scottalmond/InfoBadge/pcb/draft_1-1/img/askew.png

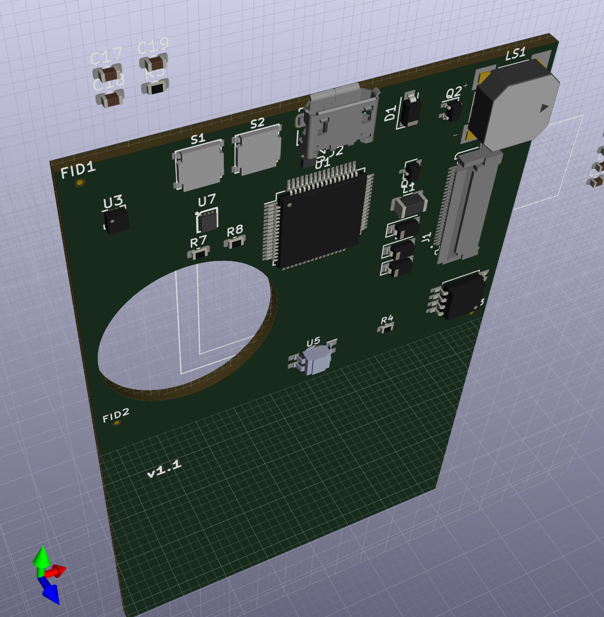
pcb/draft_1-1/img/askew.png
