scottalmond/InfoBadge/README.md

# InfoBadge
Low power wearable badge for quick-access information without wireless connectivity
