scottalmond/InfoBadge/pcb/draft_1-1/fab_notes.txt

*** update schematic license and author CC BY 4.0

*** start routing by connecting 100 nF caps near pads

x ***accel: CW/CCW reverse pins on pads
  actually, pdf view is looking up at chip, thus pads are mirrored on section 9.2, keep KiCAD AS_IS

*** update eletronic egg schematic and drawing annotation at bottom right to rev 1.2

*** verify placement of eInk header with respect to cble length from opposing side of board
*** connect analog reference https://hackaday.io/project/165887-pam8301-breakout-board

How to get debug terminal?
 Arduino Serial.setup(9600); Serial.println("test");

How to do this simple task with Atmel Studio?
  Usb examples only have echo, with no clear way to insert content between the read and write operations.  Useless as a demo of the communication protocol

DAC example non-functional.  Which pin is DAC_0? PA02 as DAC0
*NO* indication of expectations: voltage only goes up to 0.24V (0.12V when looping quickly), though multimeter had a grounding issue offset. had to add delay_ms(10); to see anything recognizable on DMM
test_analog_location3 - reached 3.3V output with 4096 steps
Need to read from PA02; and tie PA03 to ID (3.3V to VREF)

"GETTING-STARTED1.proj":
File > New > Example Project >
Family > SAML21
Search > "started"
Select: Getting-started Application - SAM L21 Xplained Pro B

Upload to target
Use Target USB at 38400 baud for messages (why isn't this terminal a feature in Atmel Studio???)

-- Getting Started Example --
-- SAML21_XPLAINED_PRO --
-- Compiled: Feb 22 2020 18:46:17 --
-- Pressing and release button SW0 should make LED0 on and off --
The output is triggered by TC counter

CONF_STDIO_BAUDRATE is 38400
keywords: configure_console, usart_get_config_defaults, stdio_serial_init, usart_enable

I want to merge "Atmel Start" project with the demo so that I can control PB06 as a debug output.  Having two projects in the same "solution" has poorly explained conflicts (will only compile the second project while igrnoing the first)

trying to add a helper file/function generates build errors

Remidned of Apollo 13 "Let's look at this as a question of status: What do we have that wroks?"

there appear to be mixed generation os libraries between "Getting started" and the "Atmel Start" projects - specifically in port_set_gpio... and gpio_set_digital... naming/usage conventions

HOW TO MERGE libraries between projects?  Want to use the UART/USB described in the "Getting started" project with the KNOWN TO WORK PB06 toggling from "Atmel Start"

Have to read between the lines to determine that a .h file is needed (error messages are useless for help)

like trying to combine two south magnets, IDE fights me every step of the way...

usart_serial_getchar
usart.c
	SercomUsart *const usart_hw = &(module->hw->USART);

	/* Check if USART has new data */
	if (!(usart_hw->INTFLAG.reg & SERCOM_USART_INTFLAG_RXC)) {
		/* Return error code */
		return STATUS_BUSY;
	}
serial.h

Also have been unable to get demo program to run on capacitive touch

usb boot loader: http://ww1.microchip.com/downloads/en/AppNotes/Atmel-42650-SAM-BA-Bootloader-for-SAM-L-Devices_ApplicationNote_AT10840.pdf
ice in production: http://ww1.microchip.com/downloads/en/AppNotes/00002466A.pdf
  https://www.highvoltagecoils.eu/2017/09/12/how-to-use-atmels-atprogram-cli-command-line-interface-to-program-a-production-file-into-an-xmega/

the atmel toolchain *requires* internet acces to make a 'Start' project

"low power" sercom?
 SERCOM5, due to its location in PD0, has a reduced feature set and does not support these features
- spi chip select
TC4 for wake-from-sleep

import arduino library I2C
C:\Users\Logic\Documents\ArduinoData\packages\arduino\hardware\samd\1.8.4\libraries\Wire

View Example Help > Offline Help
is not selectable

ASF explorer/wizard
can this work offline?

New example file frokm ASF or Extensions requires internet access

So atmel studio has a built-in browser but no terminal to communicate with chips?

12 Mhz on PL0 for CPU, 1.2 mA LDO / 0.7 mA on BUCK [Coremark]

--

50 N at 100m depth for 7.62mm dimamter

add BME280 for no particular reason
https://www.kickstarter.com/projects/463050344/ruuvitag-open-source-bluetooth-sensor-beacon
