scottalmond/InfoBadge/pcb/draft_1-1/img/front.png

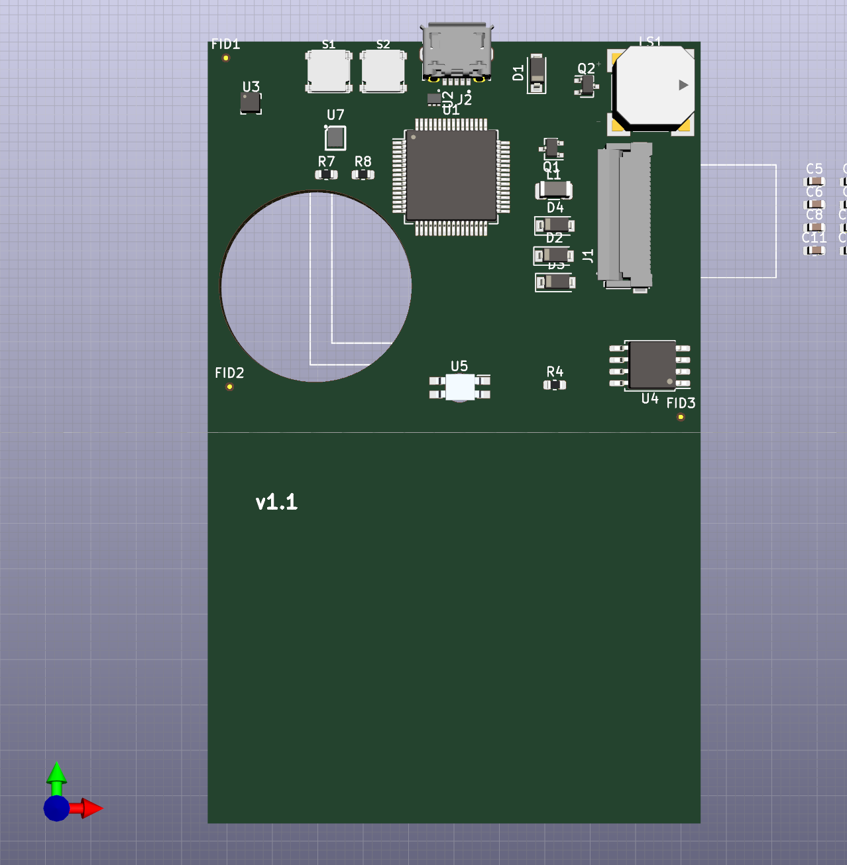
pcb/draft_1-1/img/front.png
