scottalmond/InfoBadge/pcb/draft_1-1/img/rear.png

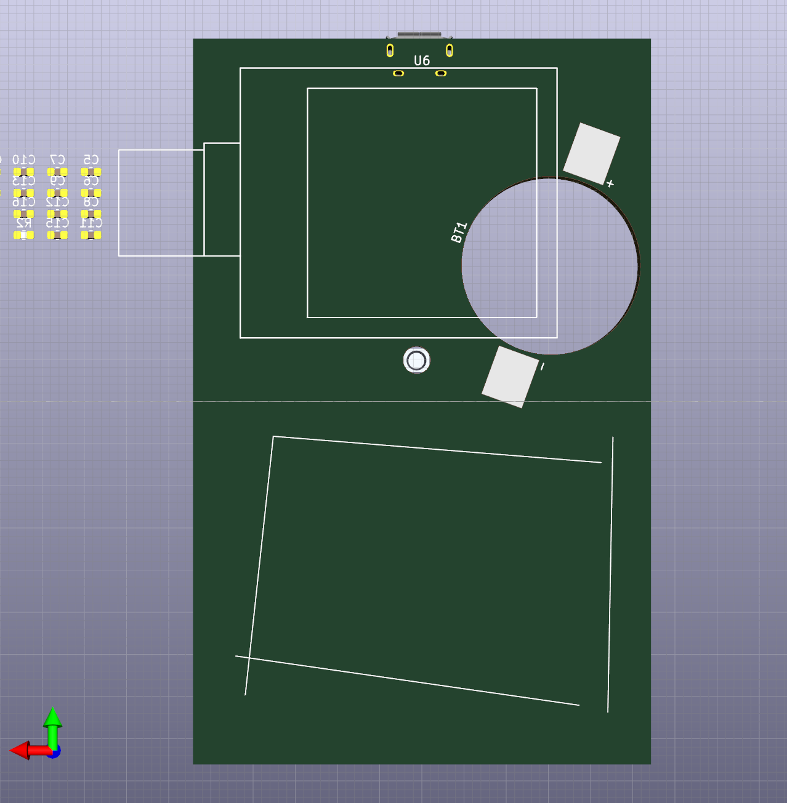
pcb/draft_1-1/img/rear.png
