scottalmond/InfoBadge/pcb/draft_1-1/img/schematic.png

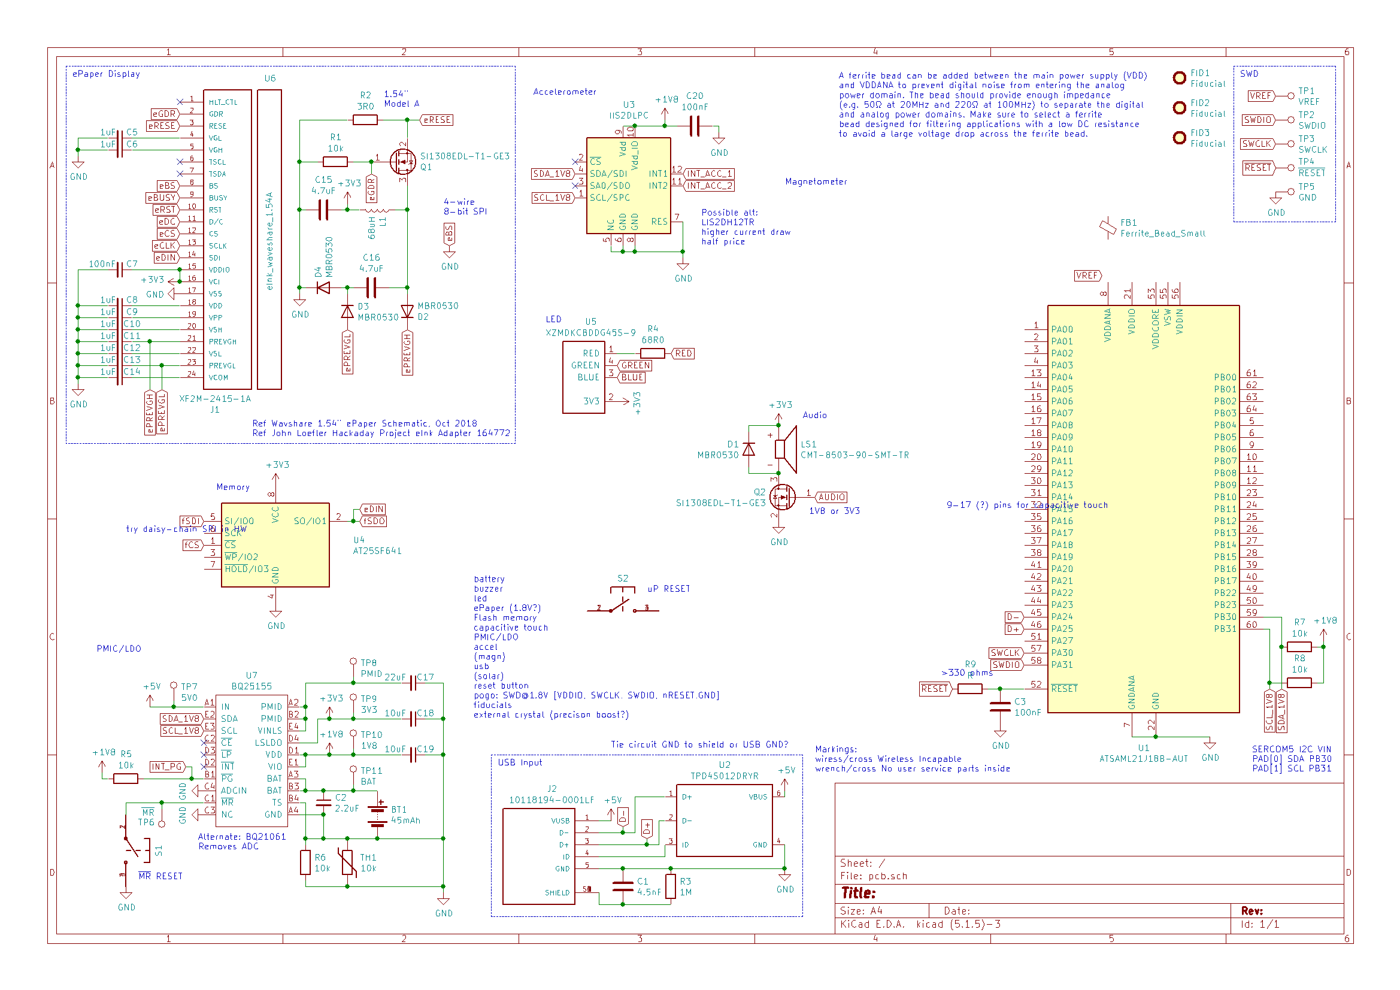
pcb/draft_1-1/img/schematic.png
