scottalmond/InfoBadge/pcb/draft_1-1/pcb/pcb.kicad_pcb

## KiCad design pcb/draft_1-1/pcb/pcb.kicad_pcb (2020-02-17)

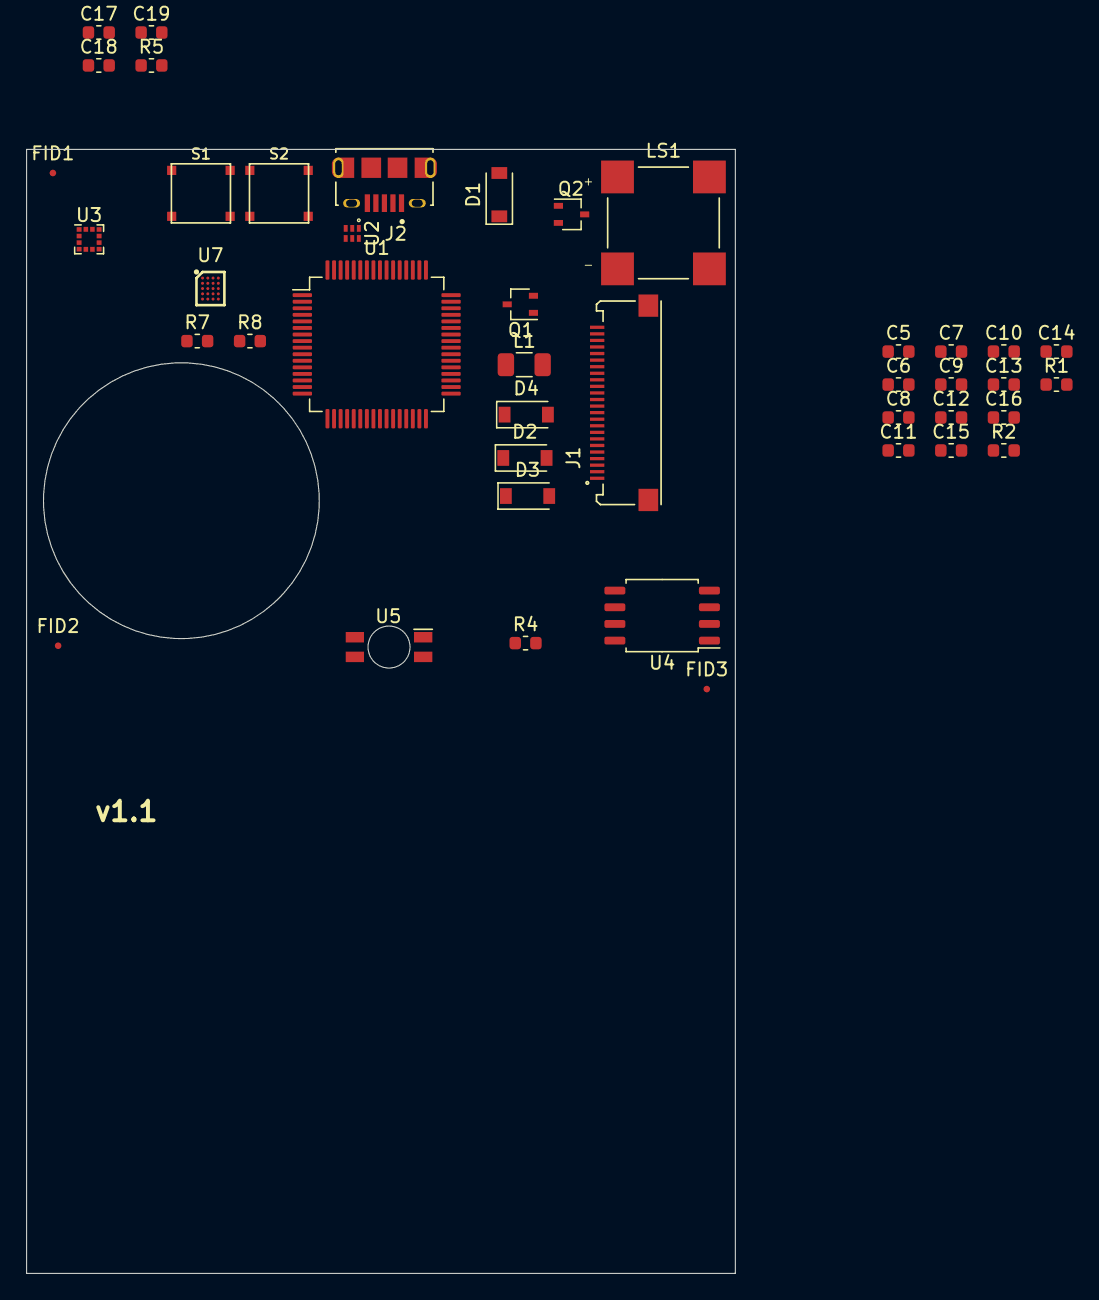
[picture p5: board pcb.kicad_pcb from above]

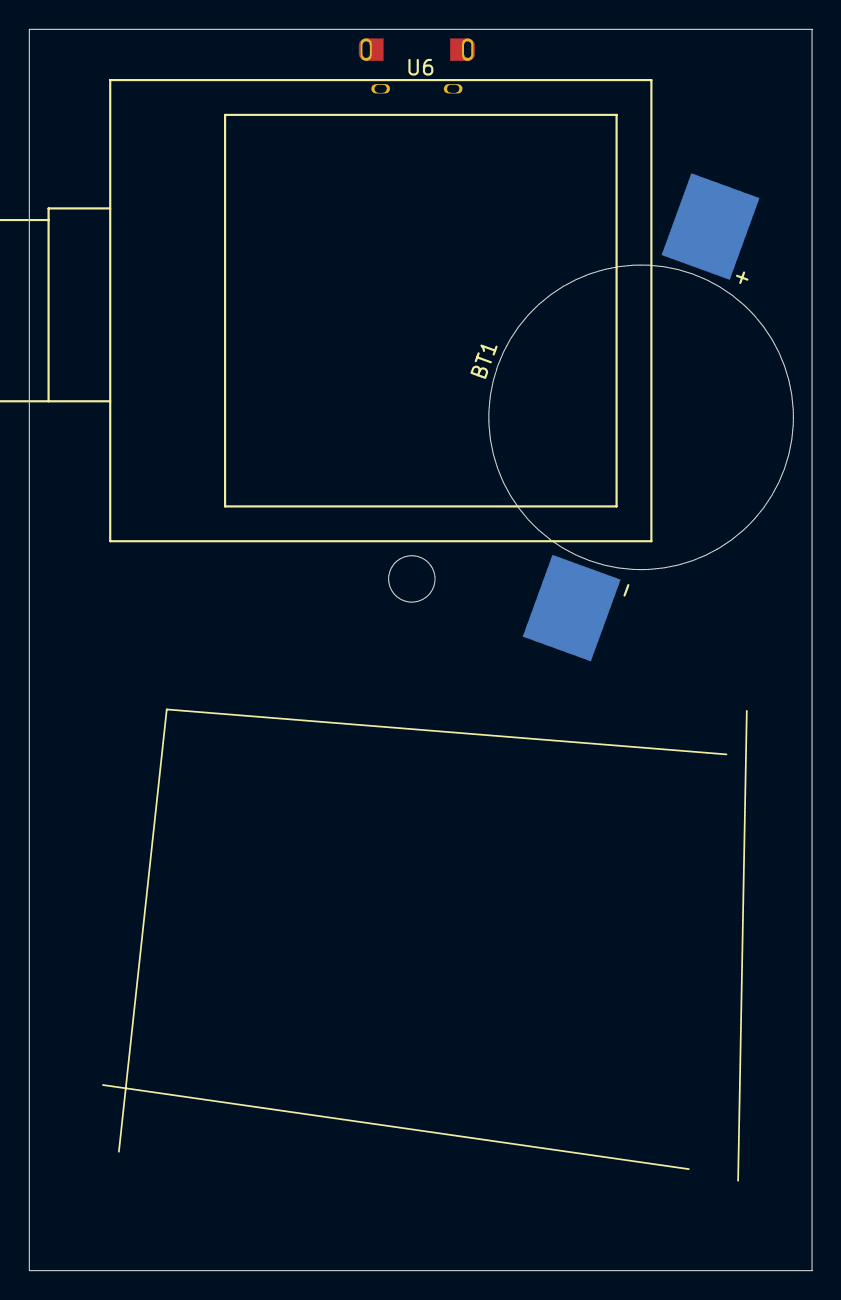
[picture p6: board pcb.kicad_pcb from below]

Board: 2 copper layers, 54.0 x 85.6 mm, 44 parts (2 on the bottom side), 33 nets, no tracks yet.

Parts:
BT1: 45mAh; LIR2032
C5, C6, C8, C9, C10, C11, C12, C13, C14: 1uF; C_0603_1608Metric
C7: 100nF; C_0603_1608Metric
C15, C16: 4.7uF; C_0603_1608Metric
C17: 22uF; C_0603_1608Metric
C18, C19: 10uF; C_0603_1608Metric
D1, D2, D3, D4: MBR0530; D_SOD-123
FID1, FID2, FID3: Fiducial; Fiducial_0.5mm_Mask1mm
J1: XF2M-2415-1A; OMRON_XF2M-2415-1A
J2: 10118194-0001LF; AMPHENOL_10118194-0001LF
L1: 68uH; L_1206_3216Metric
LS1: CMT-8503-90-SMT-TR; XDCR_CMT-8503-90-SMT-TR
Q1, Q2: SI1308EDL-T1-GE3; SOT-323_SC-70
R1, R5, R7, R8: 10k; R_0603_1608Metric
R2: 3R0; R_0603_1608Metric
R4: 68R0; R_0603_1608Metric
S1, S2: TL3315NF100Q
U1: ATSAML21J18B-AUT; TQFP-64_10x10mm_P0.5mm
U2: TPD4S012DRYR; SON50P100X145X60-6N
U3: IIS2DLPC; LGA-12_2x2mm_P0.5mm
U4: AT25SF641; SOIC-8_5.275x5.275mm_P1.27mm
U5: XZMDKCBDDG45S-9; PLCC-4
U6: eInk_waveshare_1.54A
U7: BQ25155; BGA20C40P4X5_162X202X50

Connections:
+1V8: C19.2, R5.2, R7.1, R8.1, U3.9, U3.10, U7.D1, U7.E1
+3V3: C7.1, C15.1, C18.2, D1.1, J1.15, J1.16, L1.2, LS1.P, U4.8, U5.2, U7.D4
+5V: J2.1, U2.6, U7.A1
D+: J2.3, U1.46, U2.2
D-: J2.2, U1.45, U2.1
INT_PG: R5.1, U7.B1
unnamed: U7.A3, U7.B3
unnamed: J2.S1, J2.S2, J2.S3, J2.S4, J2.S5, J2.S6
unnamed: C5.1, J1.4
unnamed: C6.1, J1.5
unnamed: C8.1, J1.18
unnamed: C9.1, J1.19
unnamed: C10.1, J1.20
unnamed: C12.1, J1.22
unnamed: C14.1, J1.24
unnamed: C16.1, D2.2, L1.1, Q1.3
unnamed: C16.2, D3.1, D4.2
unnamed: C17.2, U7.A2, U7.B2, U7.E4
unnamed: D1.2, LS1.N, Q2.3
unnamed: J2.4, U2.3
unnamed: R4.2, U5.1
unnamed: S1.1, S1.2, U7.C1
unnamed: S2.1, S2.2
unnamed: S2.3, S2.4
unnamed: U1.21, U1.34, U1.48
SCL_1V8: R8.2, U1.60, U3.1, U7.E3
SDA_1V8: R7.2, U1.59, U3.4, U7.E2
eBS: C5.2, C6.2, C7.2, C8.2, C9.2, C10.2, C11.2, C12.2, C13.2, C14.2, C15.2, C17.1, C18.1, C19.1, D4.1, J1.8, J1.17, J2.5, Q2.2, R1.2, R2.2, S1.3, S1.4, U1.7, U1.22, U1.33, U1.47, U1.54, U2.4, U3.5, U3.6, U3.7, U3.8, U4.4, U7.A4, U7.B4, U7.C3, U7.C4
eDIN: J1.14, U4.2
eGDR: J1.2, Q1.1, R1.1
ePREVGH: C11.1, D2.1, J1.21
ePREVGL: C13.1, D3.2, J1.23
eRESE: J1.3, Q1.2, R2.1
