scottalmond/InfoBadge/src/code/Arduino/project/project.ino

#include "Adafruit_MP3.h"
//#include "sine.h"

Adafruit_MP3 player;

void writeDacs(int16_t l, int16_t r){
  uint16_t val = map(l, -32768, 32767, 0, 4095);
#if defined(__SAMD51__) // feather/metro m4
  analogWrite(A0, val);
#elif defined(__MK66FX1M0__) || defined(__MK20DX256__) // teensy 3.6
  analogWrite(A21, val);
#endif
}

uint8_t *currentPtr;
uint32_t thisManyBytesLeft;

int getMoreData(uint8_t *writeHere, int thisManyBytes){
  int toWrite = min(thisManyBytesLeft, thisManyBytes);
  memcpy(writeHere, currentPtr, toWrite);
  currentPtr += toWrite;
  thisManyBytesLeft -= toWrite;
  return toWrite;
}

// the setup routine runs once when you press reset:
void setup() {

#if defined(__SAMD51__)
  //set the DAC to the center of the range
  analogWrite(A0, 2048);
#endif

  currentPtr = (uint8_t*)1;//sine_mp3;
  thisManyBytesLeft = sizeof(1);//sine_mp3);

  player.begin();

  //do this when there are samples ready
  player.setSampleReadyCallback(writeDacs);

  //do this when more data is required
  player.setBufferCallback(getMoreData);

  player.play();
}

// the loop routine runs over and over again forever:
void loop() {
  player.tick();
}

//11kB to 42.5kB --> 31.5kB for mp3 decode 
