scottalmond/InfoBadge/(commit log)

2019-12-10 concept draft
    [BOM.csv, info_badge_1-0.kicad_pcb, info_badge_1-0.sch]
2019-12-18 more research
    [BOM.csv]
2020-02-09 minor edits
    [BOM.csv, info_badge_1-0.sch, pcb.kicad_pcb, pcb.sch]
2020-02-11 paper cut out trade study
    [BOM.csv, pcb.kicad_pcb, pcb.sch]
2020-02-15 paper cutout study
    [BOM.csv, pcb.kicad_pcb, pcb.sch]
2020-02-17 trade study on speaker
    [BOM.csv, pcb.kicad_pcb, pcb.sch]
2020-02-23 experimenting with usb serial, DAC and GPO
    [BOM.csv]
2020-03-11 adding schematic
    [pcb.sch]
